LukeZhang0826/RescueRobot/Hamster/rescue_line_follower.py

import utime
from utils import clamp


class RescueLineFollower:
    STATE_TRACKING = "tracking"
    STATE_RECOVERING = "recovering"

    def __init__(self, motors, encoders, pixy, mover, cfg):
        self.motors = motors
        self.encoders = encoders
        self.pixy = pixy
        self.mover = mover
        self.cfg = cfg

    def _start_recovery(self, now_ms, last_seen_side):
        self.state = self.STATE_RECOVERING
        self.recovery_start_ms = now_ms
        self.last_seen_side = last_seen_side
        print("Line lost -> RECOVERING, turning", "right" if last_seen_side > 0 else "left")

    def _do_recovery_step(self):
        if self.last_seen_side < 0:
            self.mover.turn_left_counts(
                target_counts=self.cfg.LINE_RECOVERY_STEP_COUNTS,
                base_percent=self.cfg.LINE_RECOVERY_TURN_PERCENT,
                timeout_s=self.cfg.LINE_RECOVERY_STEP_TIMEOUT_S,
                debug=False,
            )
        else:
            self.mover.turn_right_counts(
                target_counts=self.cfg.LINE_RECOVERY_STEP_COUNTS,
                base_percent=self.cfg.LINE_RECOVERY_TURN_PERCENT,
                timeout_s=self.cfg.LINE_RECOVERY_STEP_TIMEOUT_S,
                debug=False,
            )

    def run(self):
        cfg = self.cfg

        OUTER_INTERVAL_MS = 20
        INNER_INTERVAL_MS = 20

        integral_left = 0.0
        integral_right = 0.0

        last_error_px = 0.0

        rpm_left_filtered = 0.0
        rpm_right_filtered = 0.0

        target_rpm_left = 0.0
        target_rpm_right = 0.0

        safe_confirm_count = 0
        result = "unknown"

        self.state = self.STATE_TRACKING
        self.recovery_start_ms = 0
        self.last_seen_side = cfg.LINE_RECOVERY_DEFAULT_SIDE

        self.encoders.reset()
        last_encA, last_encB = self.encoders.read_counts()

        start_ms = utime.ticks_ms()
        last_outer_ms = start_ms
        last_inner_ms = start_ms

        print("Rescue line follower started")

        try:
            while True:
                now = utime.ticks_ms()
                elapsed_s = utime.ticks_diff(now, start_ms) / 1000.0

                if elapsed_s >= cfg.RESCUE_LINE_FOLLOW_DURATION_S:
                    print("Duration reached - stopping")
                    result = "timeout"
                    break

                outer_dt_ms = utime.ticks_diff(now, last_outer_ms)
                if outer_dt_ms >= OUTER_INTERVAL_MS:
                    outer_dt = outer_dt_ms / 1000.0
                    last_outer_ms = now

                    blocks = self.pixy.get_blocks(
                        sigmap=cfg.PIXY_SIGNATURE_ALL,
                        max_blocks=10
                    )

                    safe_block = self.pixy.best_block_by_sig(
                        blocks,
                        sig=7,
                        area_min=cfg.SAFE_ZONE_AREA_MIN
                    )

                    line_block = self.pixy.best_block_by_sig(
                        blocks,
                        sig=1,
                        area_min=cfg.PIXY_AREA_MIN
                    )

                    if safe_block is not None and safe_block["area"] >= cfg.SAFE_ZONE_STOP_AREA:
                        safe_confirm_count += 1
                        print("SAFE ZONE seen | area={} count={}".format(
                            safe_block["area"], safe_confirm_count
                        ))
                    else:
                        safe_confirm_count = 0

                    if safe_confirm_count >= cfg.SAFE_ZONE_CONFIRM_FRAMES:
                        print("SAFE ZONE confirmed - braking")
                        self.motors.brake_ms(cfg.SAFE_ZONE_BRAKE_MS)
                        result = "safe_zone"
                        break

                    if line_block is None:
                        target_rpm_left = 0.0
                        target_rpm_right = 0.0
                        integral_left = 0.0
                        integral_right = 0.0
                        last_error_px = 0.0

                        if self.state != self.STATE_RECOVERING:
                            self._start_recovery(now, self.last_seen_side)
                        else:
                            recovery_elapsed = utime.ticks_diff(now, self.recovery_start_ms)
                            if recovery_elapsed >= cfg.LINE_RECOVERY_TIMEOUT_MS:
                                print("Recovery timeout")
                                result = "line_lost"
                                break
                    else:
                        if line_block["x"] < cfg.PIXY_CENTER_X:
                            self.last_seen_side = -1
                        elif line_block["x"] > cfg.PIXY_CENTER_X:
                            self.last_seen_side = 1

                        if self.state == self.STATE_RECOVERING:
                            print("Line reacquired -> TRACKING")

                        self.state = self.STATE_TRACKING

                        error_px = line_block["x"] - cfg.PIXY_CENTER_X

                        if abs(error_px) <= cfg.LINE_FOLLOW_DEADBAND_PX:
                            error_px = 0

                        if line_block["h"] >= cfg.LINE_FOLLOW_TALL_BLOCK_H:
                            error_px *= cfg.LINE_FOLLOW_TALL_BLOCK_ERROR_SCALE

                        error_derivative = (error_px - last_error_px) / outer_dt
                        last_error_px = error_px

                        turn_rpm_differential = cfg.LINE_FOLLOW_STEER_SIGN * (
                            cfg.Kp_STEER * error_px +
                            cfg.Kd_STEER * error_derivative
                        )

                        turn_rpm_differential = clamp(
                            turn_rpm_differential,
                            -cfg.LINE_FOLLOW_MAX_DIFFERENTIAL_RPM,
                            cfg.LINE_FOLLOW_MAX_DIFFERENTIAL_RPM
                        )

                        speed_scale = 1.0 - clamp(
                            abs(turn_rpm_differential) / cfg.LINE_FOLLOW_MAX_DIFFERENTIAL_RPM,
                            0.0,
                            cfg.MAX_TURNING_SLOWDOWN
                        )
                        scaled_base = cfg.LINE_FOLLOW_BASE_RPM * speed_scale
                        target_rpm_left = scaled_base + turn_rpm_differential
                        target_rpm_right = scaled_base - turn_rpm_differential

                        target_rpm_left = clamp(
                            target_rpm_left,
                            0,
                            cfg.LINE_FOLLOW_MAX_RPM
                        )
                        target_rpm_right = clamp(
                            target_rpm_right,
                            0,
                            cfg.LINE_FOLLOW_MAX_RPM
                        )

                inner_dt_ms = utime.ticks_diff(now, last_inner_ms)
                if inner_dt_ms >= INNER_INTERVAL_MS:
                    inner_dt = inner_dt_ms / 1000.0
                    last_inner_ms = now

                    if self.state == self.STATE_RECOVERING:
                        self.motors.coast()
                        self._do_recovery_step()

                        integral_left = 0.0
                        integral_right = 0.0
                        rpm_left_filtered = 0.0
                        rpm_right_filtered = 0.0
                        last_error_px = 0.0
                        target_rpm_left = 0.0
                        target_rpm_right = 0.0

                        last_encA, last_encB = self.encoders.read_counts()
                        continue

                    encA, encB = self.encoders.read_counts()
                    delta_encA = encA - last_encA
                    delta_encB = encB - last_encB
                    last_encA = encA
                    last_encB = encB

                    cps_left = delta_encB / inner_dt
                    cps_right = delta_encA / inner_dt
                    rpm_left_raw = cps_left * cfg.CPS_TO_RPM
                    rpm_right_raw = cps_right * cfg.CPS_TO_RPM

                    rpm_left_filtered += cfg.SPEED_FILTER_ALPHA * (rpm_left_raw - rpm_left_filtered)
                    rpm_right_filtered += cfg.SPEED_FILTER_ALPHA * (rpm_right_raw - rpm_right_filtered)

                    error_left = target_rpm_left - rpm_left_filtered
                    error_right = target_rpm_right - rpm_right_filtered

                    integral_left = clamp(integral_left + error_left * inner_dt, -100.0, 100.0)
                    integral_right = clamp(integral_right + error_right * inner_dt, -100.0, 100.0)

                    if target_rpm_left <= 0:
                        integral_left = 0.0
                    if target_rpm_right <= 0:
                        integral_right = 0.0

                    pwm_left = (cfg.Kp_L * error_left) + (cfg.Ki_L * integral_left)
                    pwm_right = (cfg.Kp_R * error_right) + (cfg.Ki_R * integral_right)

                    pwm_left = clamp(pwm_left, -100.0, 100.0)
                    pwm_right = clamp(pwm_right, -100.0, 100.0)

                    if cfg.USE_MIN_PWM_BOOST:
                        if target_rpm_left > 0 and 0 < pwm_left < cfg.PWM_MIN_MOVE_L:
                            pwm_left = cfg.PWM_MIN_MOVE_L
                        if target_rpm_right > 0 and 0 < pwm_right < cfg.PWM_MIN_MOVE_R:
                            pwm_right = cfg.PWM_MIN_MOVE_R

                    if target_rpm_left <= 0:
                        pwm_left = 0.0
                    if target_rpm_right <= 0:
                        pwm_right = 0.0

                    self.motors.drive_percent(pwm_left, pwm_right)

                utime.sleep_ms(5)

        finally:
            self.motors.coast()
            print("Rescue line follower stopped | result =", result)

        return result

    def stop(self):
        self.motors.coast()
