LukeZhang0826/RescueRobot/(commit log)

2026-01-30 Scaffold the PlatformIO project for the Arduino Mega
2026-01-30 Move pin assignments into pins.h
2026-01-30 Wire the Pi to the Arduino over serial
2026-01-30 Add the Arduino Mega shield KiCad project and gerbers
    [Arduino Mega Shield.kicad_pcb, Arduino Mega Shield.kicad_sch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]
2026-02-04 Finish the base PCB with a socketed buck and motor controller
    [BasePCB.kicad_pcb, BasePCB.kicad_sch, MegaShield.kicad_pcb]
2026-02-05 Add the base PCB gerbers and JLCPCB production files
    [BOM-BasePCB.csv, BOM-PCBA_Board.csv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]
2026-02-27 Add a motor control script for PWM speed management
2026-02-27 Add test firmware for the motor board
2026-03-04 Add PID speed control for the drive motors
2026-03-05 Add servo control and a camera follow routine
2026-03-05 Revert the first pass at the main mission loop
    [main.py]
2026-03-05 Add basic movement primitives and a start button
2026-03-06 Refactor servo angles and add Pixy2 camera and line follower classes
2026-03-06 Wire line following into the main loop for the first demo
2026-03-19 Add target approach and archive the old motor controller
2026-03-20 Stop after the search line follow stage
2026-03-20 Finish the state machine and add the claw controller
2026-03-23 Drop base speed to 150 rpm and retune the steering gains
2026-03-24 Retune the line follower and servo values for the competition run
2026-03-24 Shorten the safe zone and find line drive counts
    [config.py]
2026-03-26 Retune the steering limits and raise the stop target area
2026-03-26 Raise base speed to 250 rpm and narrow the turn differential
2026-03-26 Set the final competition values, 200 rpm and 1500 stop area
